martinberlin/H-epdiy-boards/epdiy-v7-model-F/fab/BOM.xlsx

Designator | Footprint | Comment | JLCPCB Part #
R15,R1,R11,R10,R4,R6,R14,R16,R33,R32 | R_0603_1608Metric | 10k | C25804
Q3,Q4 | SOT-23 | MMBT3904 | C20526
C3,C19,C9,C32,C12,C2,C16 | C_0805_2012Metric | 10uF | C28323
C22,C23,C30,C29,C15,C40,C42,C39 | C_0805_2012Metric | 100nF | C49678
D9 | LED_0805_2012Metric | LED RED | C84256
R3 | R_0603_1608Metric | 2.4k | C22940
R8 | R_0603_1608Metric | 1k | C21190
D8 | LED_0805_2012Metric | LED GREEN | C2297
C18,C13,C14 | C_0805_2012Metric | 1uF | C28323
C11,C5,C31,C8,C24,C1,C7,C4,C28,C26 | C_0805_2012Metric | 4.7uF | C1779
C34,C36 | C_1206_3216Metric | 1uF/50V | C1848
C35,C37,C38 | C_0805_2012Metric | 1uF/25V | C28323
R5 | R_0603_1608Metric | 0 | C21189
R18 | R_0603_1608Metric | 43k | C23172
R26,R27,R28,R29 | R_0603_1608Metric | 47k | C25819
TH1 | R_0603_1608Metric | 10k/3380K | C76589
U2 | TSSOP-24_4.4x7.8mm_P0.65mm | PCA9535PW | C255606
C17 | CP_EIA-3528-15_AVX-H | 100uF | C16133
R19,R23 | R_0603_1608Metric | 1M | C22935
L2 | L_Taiyo-Yuden_NR-40xx_HandSoldering | 2.2uH | C92959
L1 | L_Taiyo-Yuden_NR-50xx_HandSoldering | 4.7uH | C222947
R24 | R_0603_1608Metric | 47.5k | C25819
R20 | R_0603_1608Metric | 52.3k | C23196
U3 | TPS651851RSLR | TPS651851RSLR | C139292
C6,C10 | C_0805_2012Metric | 22uF | C45783
D6,D5,D3,D2,D4,D1,D7 | D_SOD-123 | MBR0540 | C21353
C27,C33 | C_0805_2012Metric | 2.2uF | C49217
C20,C25 | C_0805_2012Metric | 10nF | C1710
R30,R31 | R_0603_1608Metric | 100k | C25803
R22 | R_0603_1608Metric | 150k | C22807
R21 | R_0603_1608Metric | 680k | C25822
U11 | TP4056_SOP-8-PP | TP4056 | C16581
D10 | D_SOD-123 | 1N5817 | C8598
R9 | R_0603_1608Metric | 3.83k | C103591
U5 | SOT-23-3 | XC6206PxxxMR | C5446
U4 | SOT-666 | USBLC6-2P6 | C2827693
U6 | Hirose_FH12-40S-0.5SH_1x40-1MP_P0.50mm_Horizontal | ED078KH6 | C202114
Q1 | SOT-23 | AO3401A | C15127
J9,J1 | USB_C_Receptacle_HRO_TYPE-C-31-M-12 | USB_C_Receptacle_USB2.0 | C165948
C21,C41 | C_0805_2012Metric | 12pF | C1792
U7 | SOIC-8_3.9x4.9mm_P1.27mm | PCF8563T | C7440
R7,R13,R2,R12 | R_0603_1608Metric | 5.1k | C23186
J8 | HRS_FH26W-39S-0.3SHW(60) | ED133UT2 | C92280
U1 | TSOT-23-5 | RT9080-33GJ5 | C841192
J4 | FH1233S05SH55 | XF2M-3315-1A | C597986
U8 | ESP32-S3-WROOM-1 | ESP32-S3-WROOM-1 | C2913202
U9 | SOIC-16_3.9x9.9mm_P1.27mm | CH340C | C7464026
Y1 | Crystal_SMD_3215-2Pin_3.2x1.5mm | 32.768K | C32346
