martinberlin/H-epdiy-boards/epdiy-v7-model-F/parts/3d/QWIIC_SM04B-SRSS-TB_LF__SN_.stp

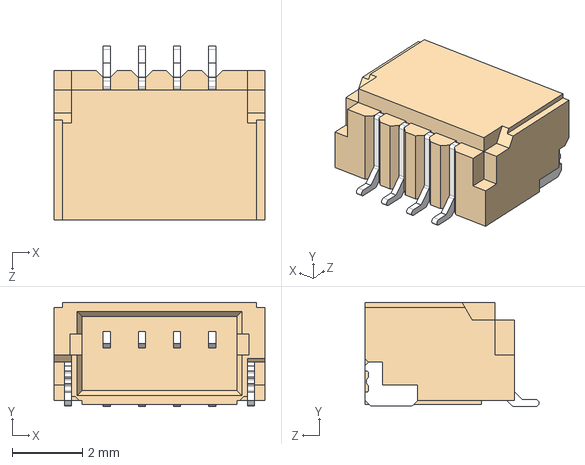
[picture p3: CAD file, 2026-09-27]
epdiy-v7-model-F/parts/3d/QWIIC_SM04B-SRSS-TB_LF__SN_.stp
6.00 x 2.96 x 4.95 mm
