martinberlin/H-epdiy-boards/epdiy-v7-model-F/parts/3d/TP4057-SOT-23.step

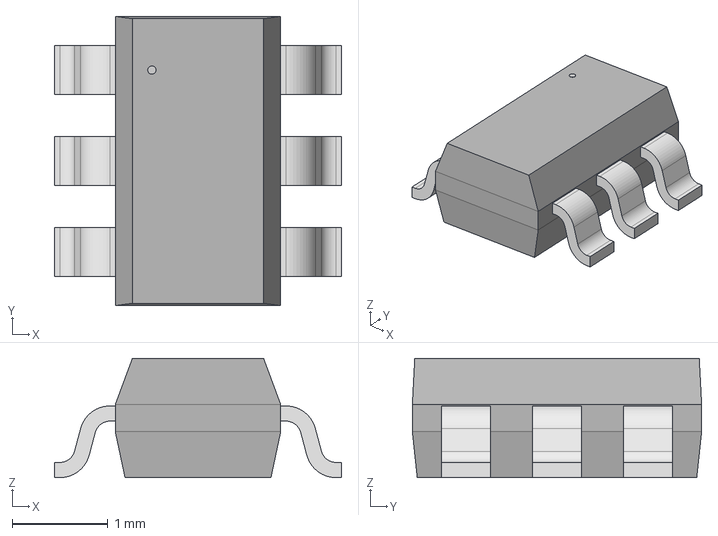
[picture p4: CAD file, 2026-09-27]
epdiy-v7-model-F/parts/3d/TP4057-SOT-23.step
3.00 x 3.02 x 1.25 mm
