martinberlin/H-epdiy-boards/epdiy-v7-model-F/parts/3d/USB_TYPE-C-31-M-12.step

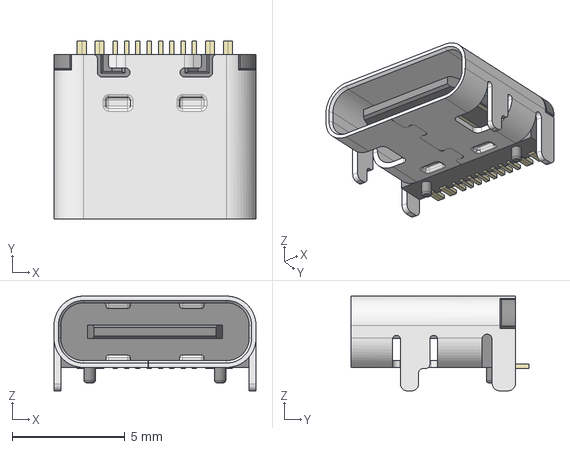
[picture p5: CAD file, 2026-09-27]
epdiy-v7-model-F/parts/3d/USB_TYPE-C-31-M-12.step
8.95 x 7.90 x 4.20 mm
