martinberlin/H-epdiy-boards/epdiy-v7-model-F/parts/3d/TPS2113APWR.stp

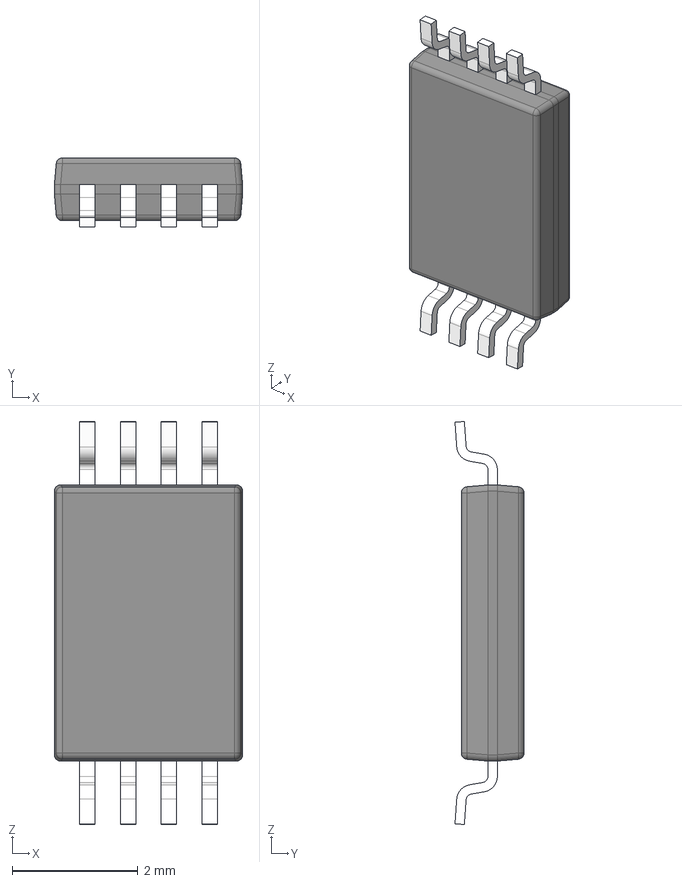
[picture p6: CAD file, 2026-09-27]
epdiy-v7-model-F/parts/3d/TPS2113APWR.stp
3.00 x 1.10 x 6.42 mm
BODY-SO
LEAD-SO x 8
PIN1-ID
