martinberlin/H-epdiy-boards/epdiy-v7-model-F/parts/3d/RV-3032-C7.stp

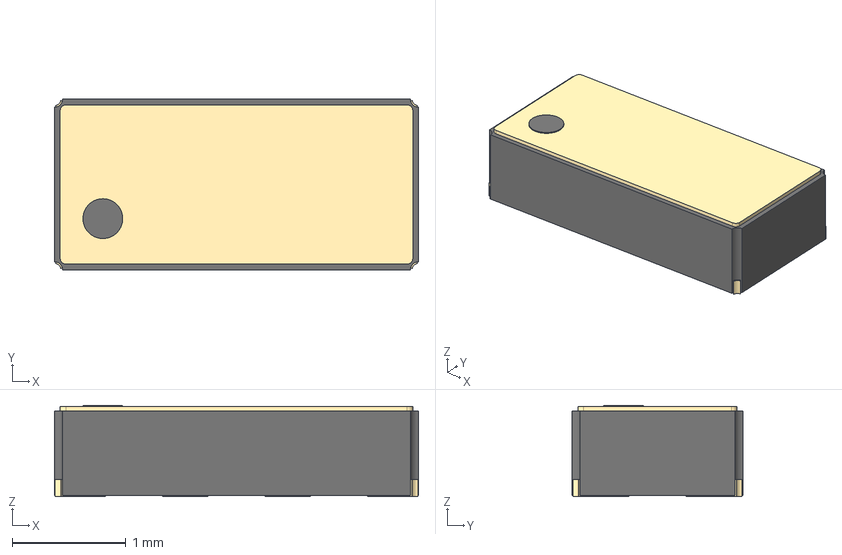
[picture p7: CAD file, 2026-09-27]
epdiy-v7-model-F/parts/3d/RV-3032-C7.stp
3.20 x 1.50 x 0.8 mm
Rect2
Rect3
Rect4
Rect5
Terminal
