martinberlin/H-epdiy-boards/common-parts/3d/C2686860_button.step

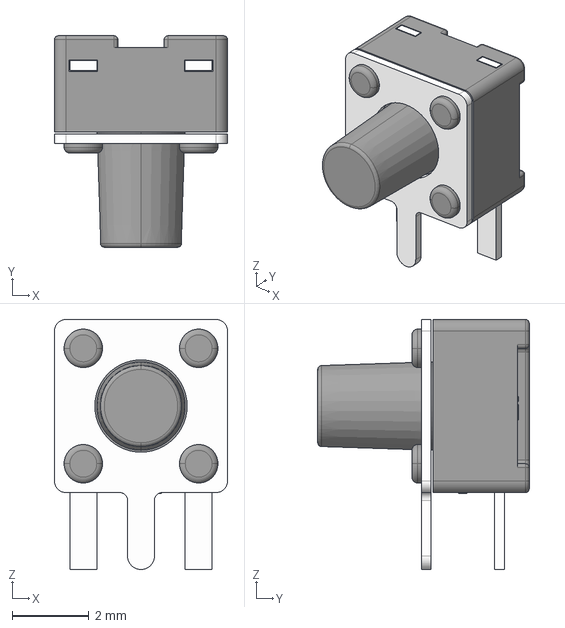
[picture p8: CAD file, 2026-10-12]
common-parts/3d/C2686860_button.step
4.50 x 5.50 x 6.50 mm
