martinberlin/H-epdiy-boards/epdiy-v7-model-F/parts/3d/C140412_CASE-B_L3.5-W2.8-H1.9.step

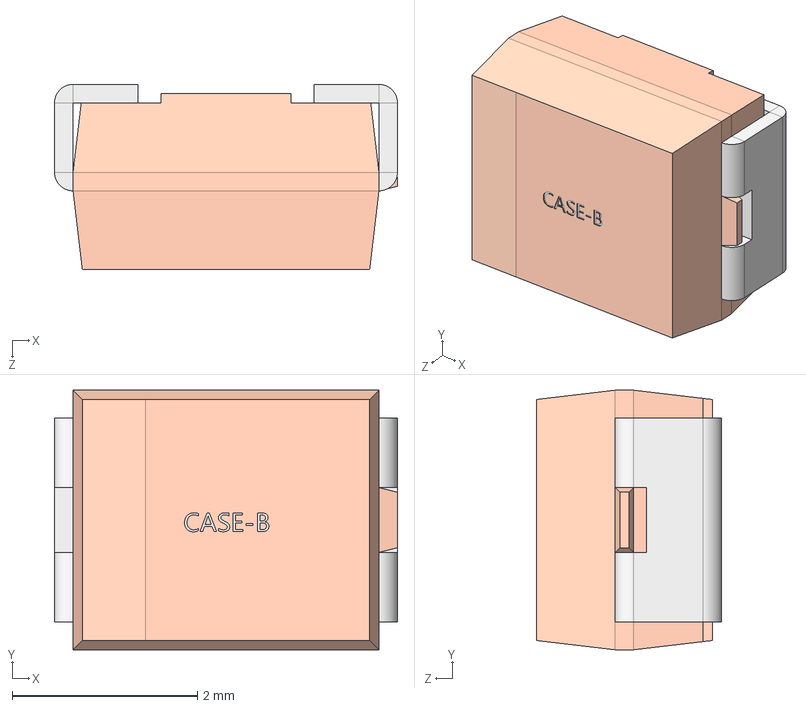
[picture p9: CAD file, 2026-09-27]
epdiy-v7-model-F/parts/3d/C140412_CASE-B_L3.5-W2.8-H1.9.step
3.70 x 2.80 x 2.00 mm
