martinberlin/H-epdiy-boards/epdiy-v7-model-F/v7-model-f_1.0.pdf

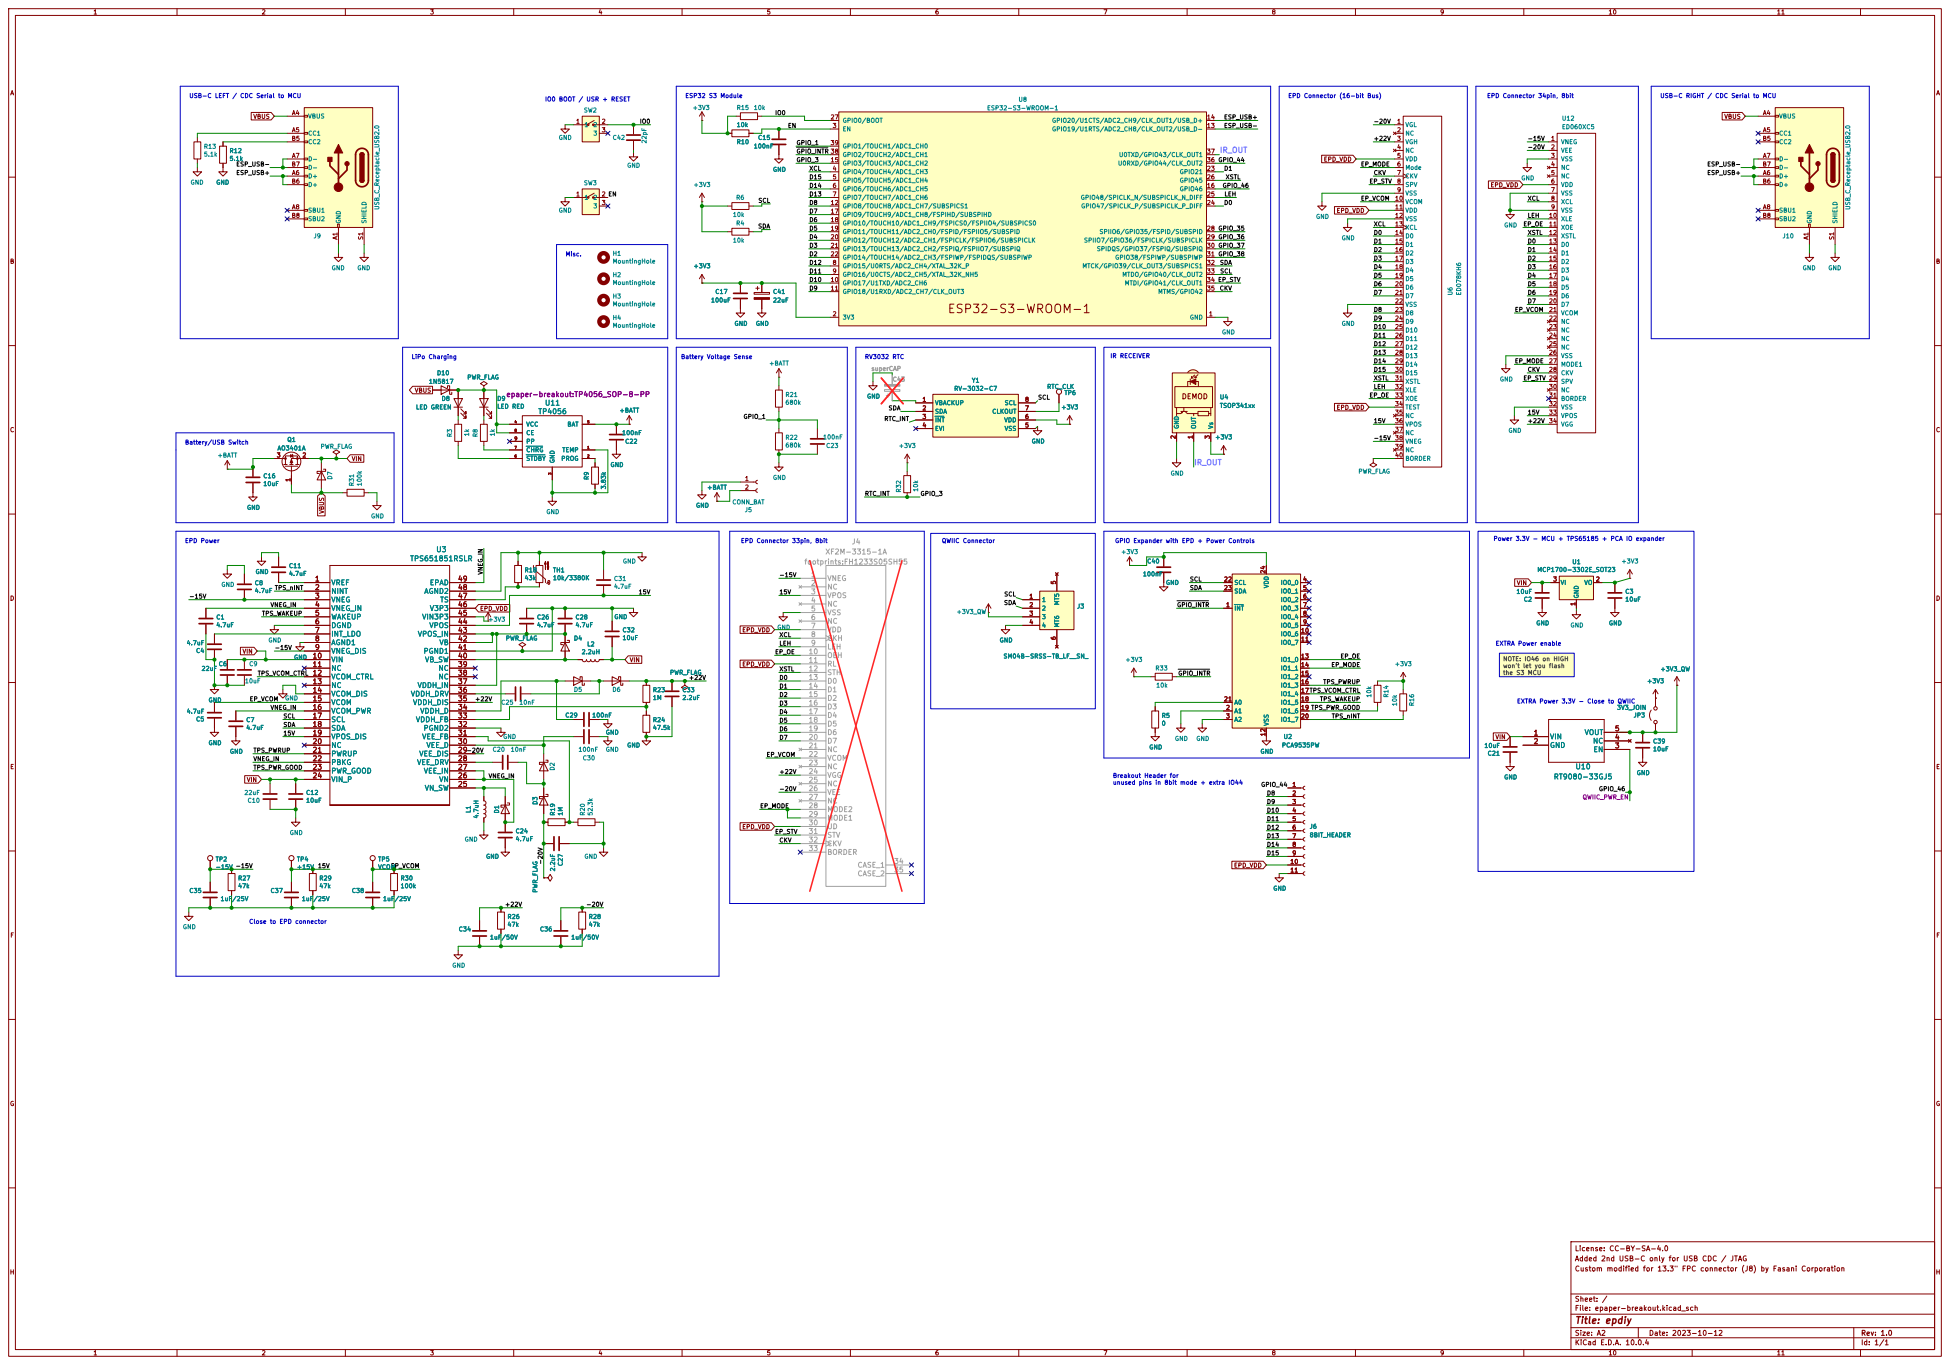
[picture p10: page 1]

USB-C LEFT / CDC Serial to MCU

USB-C RIGHT / CDC Serial to MCU

3 VCC 4 BAT 5 STDBY 6 CHRG 7 CE 8 PP 9 D10

3 VCC 4 BAT 5 STDBY 6 CHRG 7 CE 8 PP 9 U11

EPD Power Battery/USB Switch

NOTE: IO46 on HIGH
won't let you flash
the S3 MCU

Breakout Header for unused pins in 8bit mode + extra IO44

Close to EPD connector

License: CC-BY-SA-4.0
Added 2nd USB-C only for USB CDC / JTAG
Custom modified for 13.3" FPC connector (J8) by Fasani Corporation

Size: A2 | Rev: 1.0
KiCad E.D.A. 10.0.4 | Id: 1/1
