martinberlin/H-epdiy-boards/epdiy-v7-model-F/epaper-breakout.kicad_pcb

## KiCad design epdiy-v7-model-F/epaper-breakout.kicad_pcb (2026-11-10)

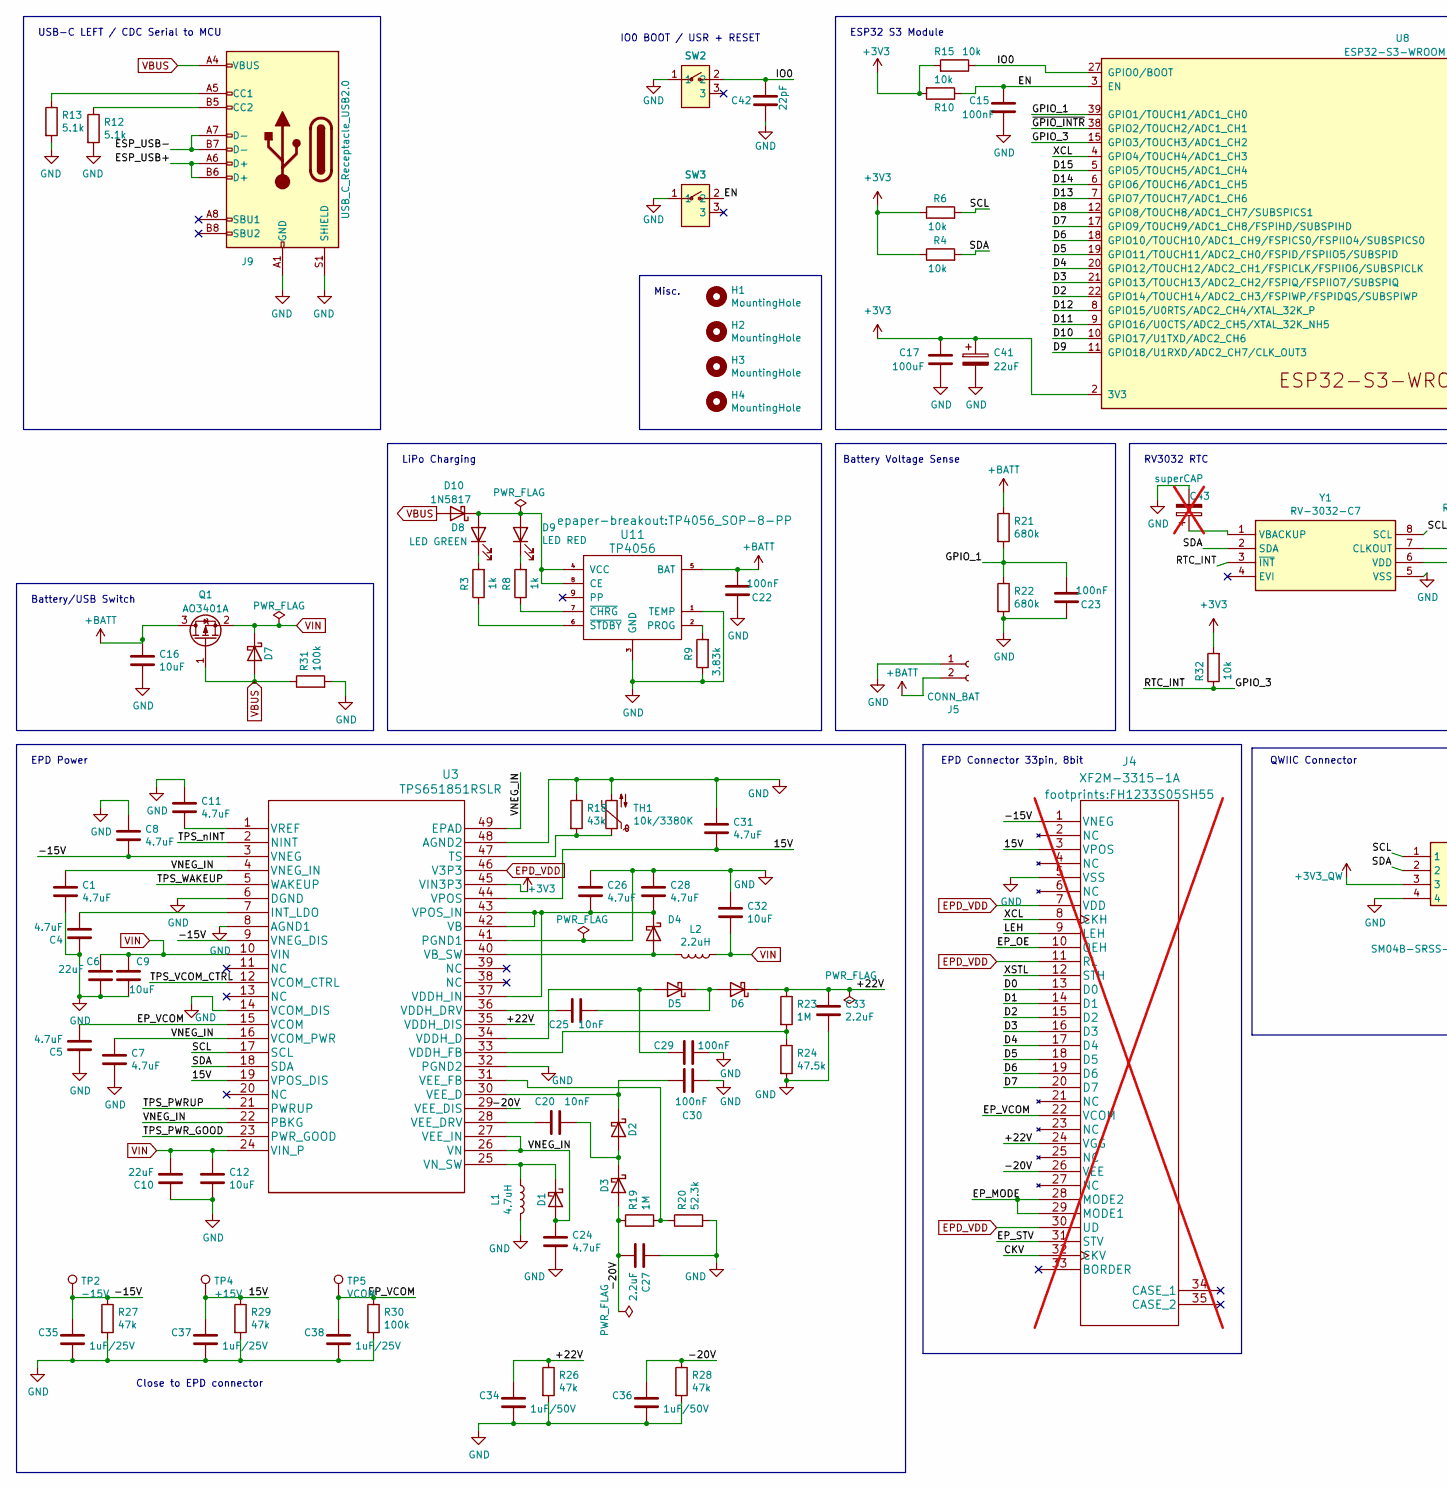
[picture p11: schematic epaper-breakout.kicad_sch, epdiy, part in row 1, column 1]

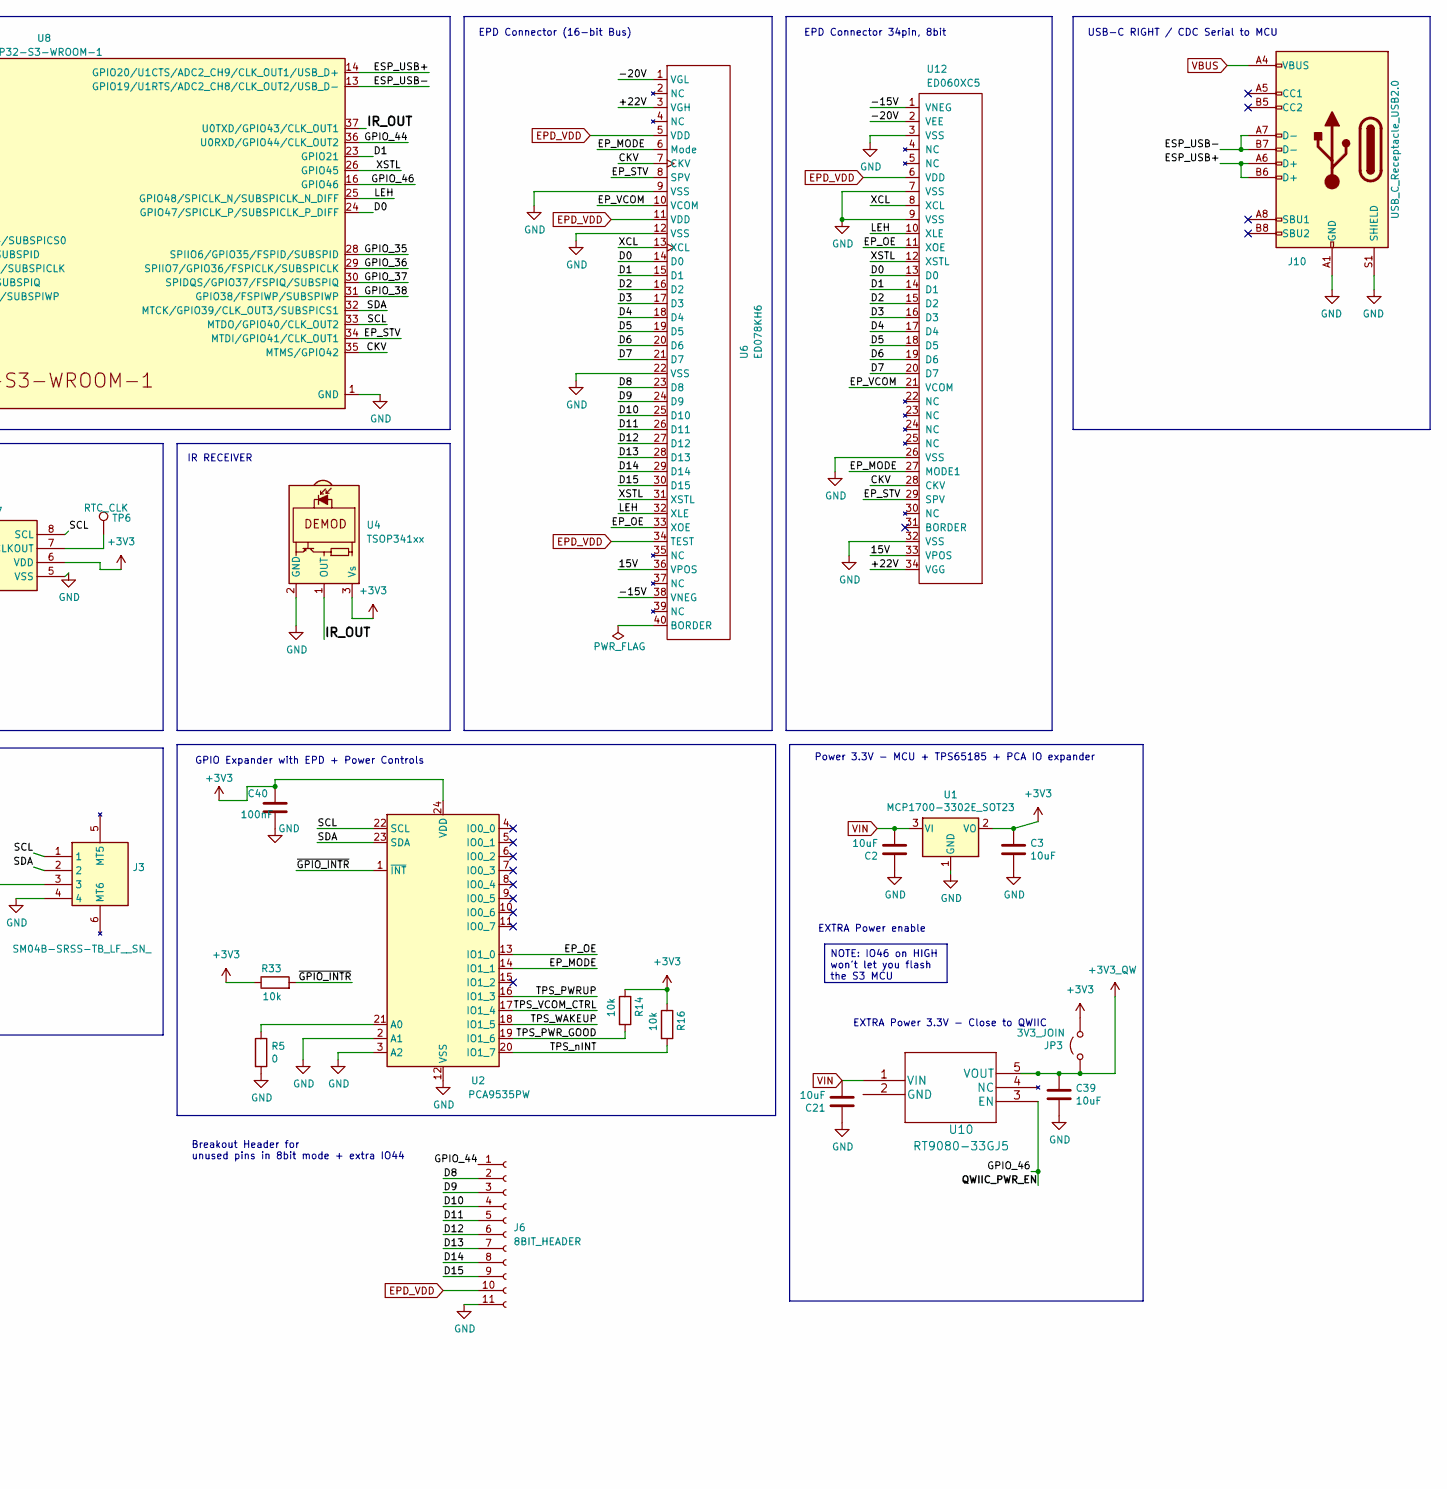
[picture p12: schematic epaper-breakout.kicad_sch, epdiy, part in row 1, column 2]

Parts:
C1, C4, C5, C7, C8, C11, C24, C26, C28, C31: 4.7uF; C_0805_2012Metric; LCSC C1779
C2, C3, C9, C12, C16, C21, C32, C39: 10uF; C_0805_2012Metric; LCSC C15850
C6, C10: 22uF; C_0805_2012Metric; LCSC C45783
C15, C22, C23, C29, C30, C40: 100nF; C_0805_2012Metric; LCSC C49678
C17: 100uF; CP_EIA-3528-15_AVX-H; LCSC C16133
C20, C25: 10nF; C_0805_2012Metric; LCSC C1710
C27, C33: 2.2uF; C_0805_2012Metric; LCSC C49217
C34, C36: 1uF/50V; C_1206_3216Metric; LCSC C1848
C35, C37, C38: 1uF/25V; C_0805_2012Metric; LCSC C28323
C41: 22uF; C140412_CAP-SMD_L3.5-W2.8; LCSC C140412
C42: 22pF; C_0402_1005Metric; LCSC C5119318
C43: superCAP; C9900013866_SUPERCAP-TH_XH414HG; LCSC C9900013866; not fitted
D1, D2, D3, D4, D5, D6, D7: MBR0540; D_SOD-123; LCSC C21353
D8: LED GREEN; LED_0805_2012Metric; LCSC C2297
D9: LED RED; LED_0805_2012Metric; LCSC C84256
D10: 1N5817; D_SOD-123; LCSC C8598
H1, H2, H3, H4: MountingHole; MountingHole_2.2mm_M2
J3: SM04B-SRSS-TB_LF__SN_; QWIIC_SM04B-SRSS-TB_LFSN_; Manufacturer_Part_Number SM04B-SRSS-TB(LF)(SN); LCSC C160404
J4: XF2M-3315-1A; FH1233S05SH55; LCSC C597986; not fitted
J5: CONN_BAT; PinHeader_1x02_P2.54mm_Vertical
J6: 8BIT_HEADER; PinHeader_1x11_P2.54mm_Vertical
J9, J10: USB_C_Receptacle_USB2.0; USB_C_Receptacle_HRO_TYPE-C-31-M-12; LCSC C165948
JP3: 3V3_JOIN; SolderJumper-2_P1.3mm_Open_RoundedPad1.0x1.5mm
L1: 4.7uH; L_Taiyo-Yuden_NR-50xx_HandSoldering; LCSC C222947
L2: 2.2uH; L_Taiyo-Yuden_NR-40xx_HandSoldering; LCSC C92959
Q1: AO3401A; SOT-23; LCSC C15127
R3, R8: 1k; R_0603_1608Metric; LCSC C21190
R4, R6, R10, R14, R15, R16, R32, R33: 10k; R_0603_1608Metric; LCSC C25804
R5: 0; R_0603_1608Metric; LCSC C21189
R9: 3.83k; R_0603_1608Metric; LCSC C103591
R12, R13: 5.1k; R_0603_1608Metric; LCSC C23186
R18: 43k; R_0603_1608Metric; LCSC C23172
R19, R23: 1M; R_0603_1608Metric; LCSC C22935
R20: 52.3k; R_0603_1608Metric; LCSC C23196
R21, R22: 680k; R_0603_1608Metric; LCSC C25822
R24: 47.5k; R_0603_1608Metric; LCSC C25819
R26, R27, R28, R29: 47k; R_0603_1608Metric; LCSC C25819
R30, R31: 100k; R_0603_1608Metric; LCSC C25803
SW2, SW3: HX-3X6X3.5-CA-0.6-2.5N; C2686860_button_TC073B-H055-L1; LCSC C2686860
TH1: 10k/3380K; R_0603_1608Metric; LCSC C76589
TP2: -15V; TestPoint_Pad_D2.5mm
TP4: +15V; TestPoint_Pad_D2.5mm
TP5: VCOM; TestPoint_Pad_D2.5mm
TP6: RTC_CLK; TestPoint_Pad_1.0x1.0mm
U1: MCP1700-3302E_SOT23; SOT-23; LCSC C39051
U2: PCA9535PW; TSSOP-24_4.4x7.8mm_P0.65mm; LCSC C255606
U3: TPS651851RSLR; LCSC C139292
U4: TSOP341xx; Vishay_MOLD-3Pin; LCSC C118303
U6: ED078KH6; Hirose_FH12-40S-0.5SH_mirrored; LCSC C202114
U8: ESP32-S3-WROOM-1; LCSC C2913202
U10: RT9080-33GJ5; TSOT-23-5; LCSC C841192
U11: TP4056; TP4056_SOP-8-PP; LCSC C16581
U12: ED060XC5; X05A20H34G; LCSC C528053
Y1: RV-3032-C7; RV3032C7; Manufacturer_Part_Number RV-3032-C7; LCSC C5127802

Connections:
+3V3: C3.2, C17.1, C40.1, C41.1, JP3.2 (B), R4.1, R6.1, R10.2, R14.1, R15.2, R16.1, R32.2, R33.1, U1.2 (VO), U2.24 (VDD), U3.45 (VIN3P3), U4.3 (Vs), U8.2 (3V3), Y1.6 (VDD)
+3V3_QW: C39.2, J3.3, JP3.1 (A), U10.5 (VOUT)
+BATT: C16.2, C22.2, J5.2, Q1.3 (D), R21.1, U11.5 (BAT)
/15V: C31.2, C37.1, J4.3 (VPOS), R29.1, TP4.1 (1_1), U3.19 (VPOS_DIS), U3.44 (VPOS), U6.36 (VPOS), U12.33 (VPOS)
/+22V: C33.1, C34.1, D6.1 (K), J4.24 (VGG), R23.1, R26.1, U3.35 (VDDH_DIS), U6.3 (VGH), U12.34 (VGG)
/-15V: C8.2, C35.1, J4.1 (VNEG), R27.1, TP2.1 (1_1), U3.3 (VNEG), U3.9 (VNEG_DIS), U6.38 (VNEG), U12.1 (VNEG)
/-20V: C27.2, C36.1, D3.2 (A), J4.26 (VEE), R19.1, R28.1, U3.29 (VEE_DIS), U6.1 (VGL), U12.2 (VEE)
/CKV: J4.32 (CKV), U6.7 (CKV), U8.35 (MTMS/GPIO42), U12.28 (CKV)
/D0: J4.13 (D0), U6.14 (D0), U8.24 (GPIO47/SPICLK_P/SUBSPICLK_P_DIFF), U12.13 (D0)
/D1: J4.14 (D1), U6.15 (D1), U8.23 (GPIO21), U12.14 (D1)
/D2: J4.15 (D2), U6.16 (D2), U8.22 (GPIO14/TOUCH14/ADC2_CH3/FSPIWP/FSPIDQS/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), U12.15 (D2)
/D3: J4.16 (D3), U6.17 (D3), U8.21 (GPIO13/TOUCH13/ADC2_CH2/FSPIQ/FSPIIO7/S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), U12.16 (D3)
/D4: J4.17 (D4), U6.18 (D4), U8.20 (GPIO12/TOUCH12/ADC2_CH1/FSPICLK/FSPIIO6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), U12.17 (D4)
/D5: J4.18 (D5), U6.19 (D5), U8.19 (GPIO11/TOUCH11/ADC2_CH0/FSPID/FSPIIO5/S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), U12.18 (D5)
/D6: J4.19 (D6), U6.20 (D6), U8.18 (GPIO10/TOUCH10/ADC1_CH9/FSPICS0/FSPIIO4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), U12.19 (D6)
/D7: J4.20 (D7), U6.21 (D7), U8.17 (GPIO9/TOUCH9/ADC1_CH8/FSPIHD/SUBSPIHD), U12.20 (D7)
/D8: J6.2, U6.23 (D8), U8.12 (GPIO8/TOUCH8/ADC1_CH7/SUBSPICS1)
/D9: J6.3, U6.24 (D9), U8.11 (GPIO18/U1RXD/ADC2_CH7/CLK_OUT3)
/D10: J6.4, U6.25 (D10), U8.10 (GPIO17/U1TXD/ADC2_CH6)
/D11: J6.5, U6.26 (D11), U8.9 (GPIO16/U0CTS/ADC2_CH5/XTAL_32K_NH5)
/D12: J6.6, U6.27 (D12), U8.8 (GPIO15/U0RTS/ADC2_CH4/XTAL_32K_P)
/D13: J6.7, U6.28 (D13), U8.7 (GPIO7/TOUCH7/ADC1_CH6)
/D14: J6.8, U6.29 (D14), U8.6 (GPIO6/TOUCH6/ADC1_CH5)
/D15: J6.9, U6.30 (D15), U8.5 (GPIO5/TOUCH5/ADC1_CH4)
/EN: C15.1, R10.1, SW3.2, U8.3 (EN)
/EP_MODE: J4.28 (MODE2), J4.29 (MODE1), U2.14 (IO1_1), U6.6 (Mode), U12.27 (MODE1)
/EP_OE: J4.10 (OEH), U2.13 (IO1_0), U6.33 (XOE), U12.11 (XOE)
/EP_STV: J4.31 (STV), U6.8 (SPV), U8.34 (MTDI/GPIO41/CLK_OUT1), U12.29 (SPV)
/EP_VCOM: C5.2, C38.1, J4.22 (VCOM), R30.1, TP5.1 (1_1), U3.15 (VCOM), U6.10 (VCOM), U12.21 (VCOM)
/ESP_USB+: J9.A6 (D+), J9.B6 (D+), J10.A6 (D+), J10.B6 (D+), U8.14 (GPIO20/U1CTS/ADC2_CH9/CLK_OUT1/USB_D+)
/ESP_USB-: J9.A7 (D-), J9.B7 (D-), J10.A7 (D-), J10.B7 (D-), U8.13 (GPIO19/U1RTS/ADC2_CH8/CLK_OUT2/USB_D-)
/GPIO_1: C23.2, R21.2, R22.1, U8.39 (GPIO1/TOUCH1/ADC1_CH0)
/GPIO_3: R32.1, U8.15 (GPIO3/TOUCH3/ADC1_CH2), Y1.3 (~INT)
/GPIO_35: U8.28 (SPIIO6/GPIO35/FSPID/SUBSPID)
/GPIO_36: U8.29 (SPIIO7/GPIO36/FSPICLK/SUBSPICLK)
/GPIO_37: U8.30 (SPIDQS/GPIO37/FSPIQ/SUBSPIQ)
/GPIO_38: U8.31 (GPIO38/FSPIWP/SUBSPIWP)
/GPIO_44: J6.1, U8.36 (U0RXD/GPIO44/CLK_OUT2)
/GPIO_46: U8.16 (GPIO46), U10.3 (EN)
/IO0: C42.2, R15.1, SW2.2, U8.27 (GPIO0/BOOT)
/IR_OUT: U4.1 (OUT), U8.37 (U0TXD/GPIO43/CLK_OUT1)
/LEH: J4.9 (LEH), U6.32 (XLE), U8.25 (GPIO48/SPICLK_N/SUBSPICLK_N_DIFF), U12.10 (XLE)
/SCL: J3.1, R6.2, U2.22 (SCL), U3.17 (SCL), U8.33 (MTDO/GPIO40/CLK_OUT2), Y1.8 (SCL)
/SDA: J3.2, R4.2, U2.23 (SDA), U3.18 (SDA), U8.32 (MTCK/GPIO39/CLK_OUT3/SUBSPICS1), Y1.2 (SDA)
/TPS_PWRUP: U2.16 (IO1_3), U3.21 (PWRUP)
/TPS_PWR_GOOD: R14.2, U2.19 (IO1_6), U3.23 (PWR_GOOD)
/TPS_VCOM_CTRL: U2.17 (IO1_4), U3.12 (VCOM_CTRL)
/TPS_WAKEUP: U2.18 (IO1_5), U3.5 (WAKEUP)
/TPS_nINT: R16.2, U2.20 (IO1_7), U3.2 (NINT)
/VNEG_IN: C1.1, C7.1, C24.1, D1.2 (A), U3.4 (VNEG_IN), U3.16 (VCOM_PWR), U3.22 (PBKG), U3.26 (VN), U3.27 (VEE_IN), U3.49 (EPAD)
/XCL: J4.8 (CKH), U6.13 (XCL), U8.4 (GPIO4/TOUCH4/ADC1_CH3), U12.8 (XCL)
/XSTL: J4.12 (STH), U6.31 (XSTL), U8.26 (GPIO45), U12.12 (XSTL)
/~GPIO_INTR: R33.2, U2.1 (~INT), U8.38 (GPIO2/TOUCH2/ADC1_CH1)
EPD_VDD: J4.7 (VDD), J4.11 (RL), J4.30 (UD), J6.10, U3.46 (V3P3), U6.5 (VDD), U6.11 (VDD), U6.34 (TEST), U12.6 (VDD)
unnamed: D1.1 (K), L1.1, U3.25 (VN_SW)
unnamed: C20.1, D2.2 (A), D3.1 (K)
unnamed: C30.1, D2.1 (K), U3.30 (VEE_D)
unnamed: D4.2 (A), L2.2, U3.40 (VB_SW)
unnamed: C26.2, C28.2, D4.1 (K), U3.37 (VDDH_IN), U3.42 (VB), U3.43 (VPOS_IN)
unnamed: C29.2, D5.2 (A), U3.34 (VDDH_D)
unnamed: C25.1, D5.1 (K), D6.2 (A)
unnamed: D8.1 (K), R3.2
unnamed: D9.1 (K), R8.2
unnamed: D8.2 (A), D9.2 (A), D10.1 (K), U11.4 (VCC), U11.8 (CE)
unnamed: J9.A5 (CC1), R13.1
unnamed: J9.B5 (CC2), R12.1
unnamed: R5.1, U2.21 (A0)
unnamed: C4.2, U3.7 (INT_LDO)
unnamed: R18.2, TH1.1, U3.47 (TS)
unnamed: C25.2, U3.36 (VDDH_DRV)
unnamed: R23.2, R24.1, U3.33 (VDDH_FB)
unnamed: C20.2, U3.28 (VEE_DRV)
unnamed: R19.2, R20.1, U3.31 (VEE_FB)
unnamed: C11.2, U3.1 (VREF)
unnamed: R9.2, U11.2 (PROG)
unnamed: R8.1, U11.7 (~CHRG)
unnamed: R3.1, U11.6 (~STDBY)
unnamed: TP6.1 (1_1), Y1.7 (CLKOUT)
unnamed: C43.1, Y1.1 (VBACKUP)
VBUS: D7.2 (A), D10.2 (A), J9.A4 (VBUS), J9.A9 (VBUS), J9.B4 (VBUS), J9.B9 (VBUS), J10.A4 (VBUS), J10.A9 (VBUS), J10.B4 (VBUS), J10.B9 (VBUS), Q1.1 (G), R31.1
VIN: C2.1, C6.2, C9.1, C10.2, C12.1, C21.1, C32.2, D7.1 (K), L2.1, Q1.2 (S), U1.3 (VI), U3.10 (VIN), U3.24 (VIN_P), U10.1 (VIN)

Notes on the sheet:
Battery Voltage Sense
QWIIC Connector
Misc.
USB-C RIGHT / CDC Serial to MCU
IR RECEIVER
EPD Power
GPIO Expander with EPD + Power Controls
EPD Connector (16-bit Bus)
ESP32 S3 Module
USB-C LEFT / CDC Serial to MCU
EXTRA Power enable
Power 3.3V - MCU + TPS65185 + PCA IO expander
EPD Connector 33pin, 8bit
Battery/USB Switch
RV3032 RTC
EXTRA Power 3.3V - Close to QWIIC
EPD Connector 34pin, 8bit
Breakout Header for unused pins in 8bit mode + extra IO44
IO0 BOOT / USR + RESET
LiPo Charging
Close to EPD connector
NOTE: IO46 on HIGH won't let you flash the S3 MCU

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
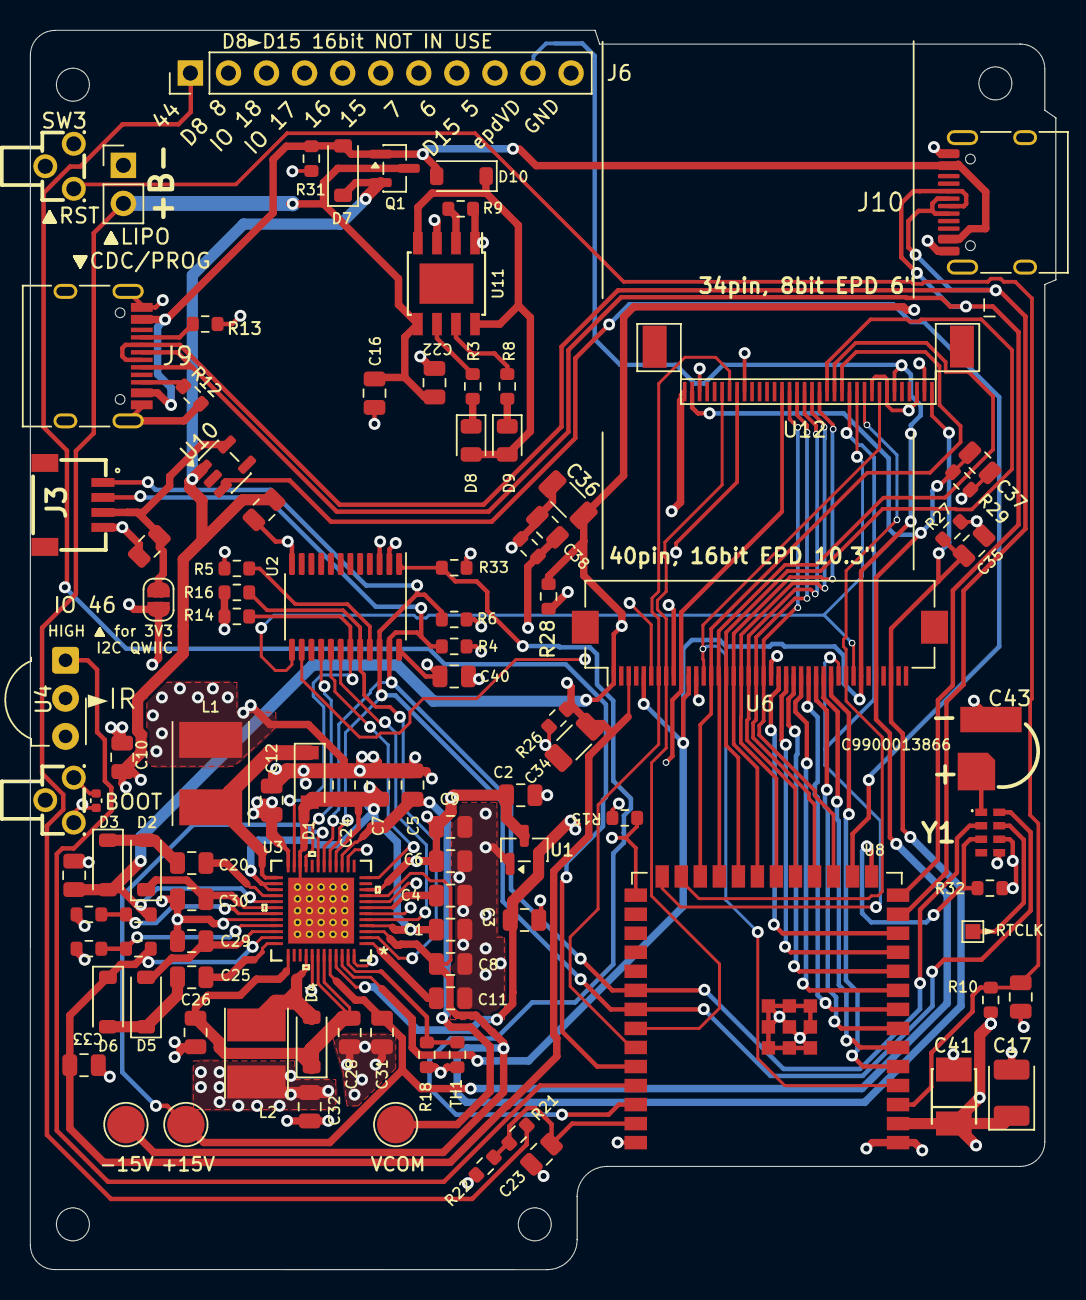
[picture p13: board epaper-breakout.kicad_pcb from above]

Board: 4 copper layers, 68.4 x 82.7 mm, 106 parts (0 on the bottom side), 78 nets.
