martinberlin/H-epdiy-boards/(commit log)

2026-09-27 Add common parts for epdiy / fastEPD PCB versions
    [BOM.xlsx, C140412_CASE-B_L3.5-W2.8-H1.9.step, QWIIC_SM04B-SRSS-TB_LF__SN_.stp, RV-3032-C7.stp, TP4057-SOT-23.step, TPS2113APWR.stp, USB_TYPE-C-31-M-12.step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]
2026-10-04 Starting to accomodate stuff over the board
    [epaper-breakout.kicad_pcb, epaper-breakout.kicad_sch]
2026-10-15 Update 33 pin w/34 and add 2nd USBC
